RealSynarix/CustomMouse/(list of files, cad)

Other CAD files:
Hardware/Models/model.stl
