RealSynarix/CustomMouse/Hardware/PCB/Schematic_KiCAD.sch

## KiCad design Hardware/PCB/Schematic_KiCAD.sch (2026-02-08)

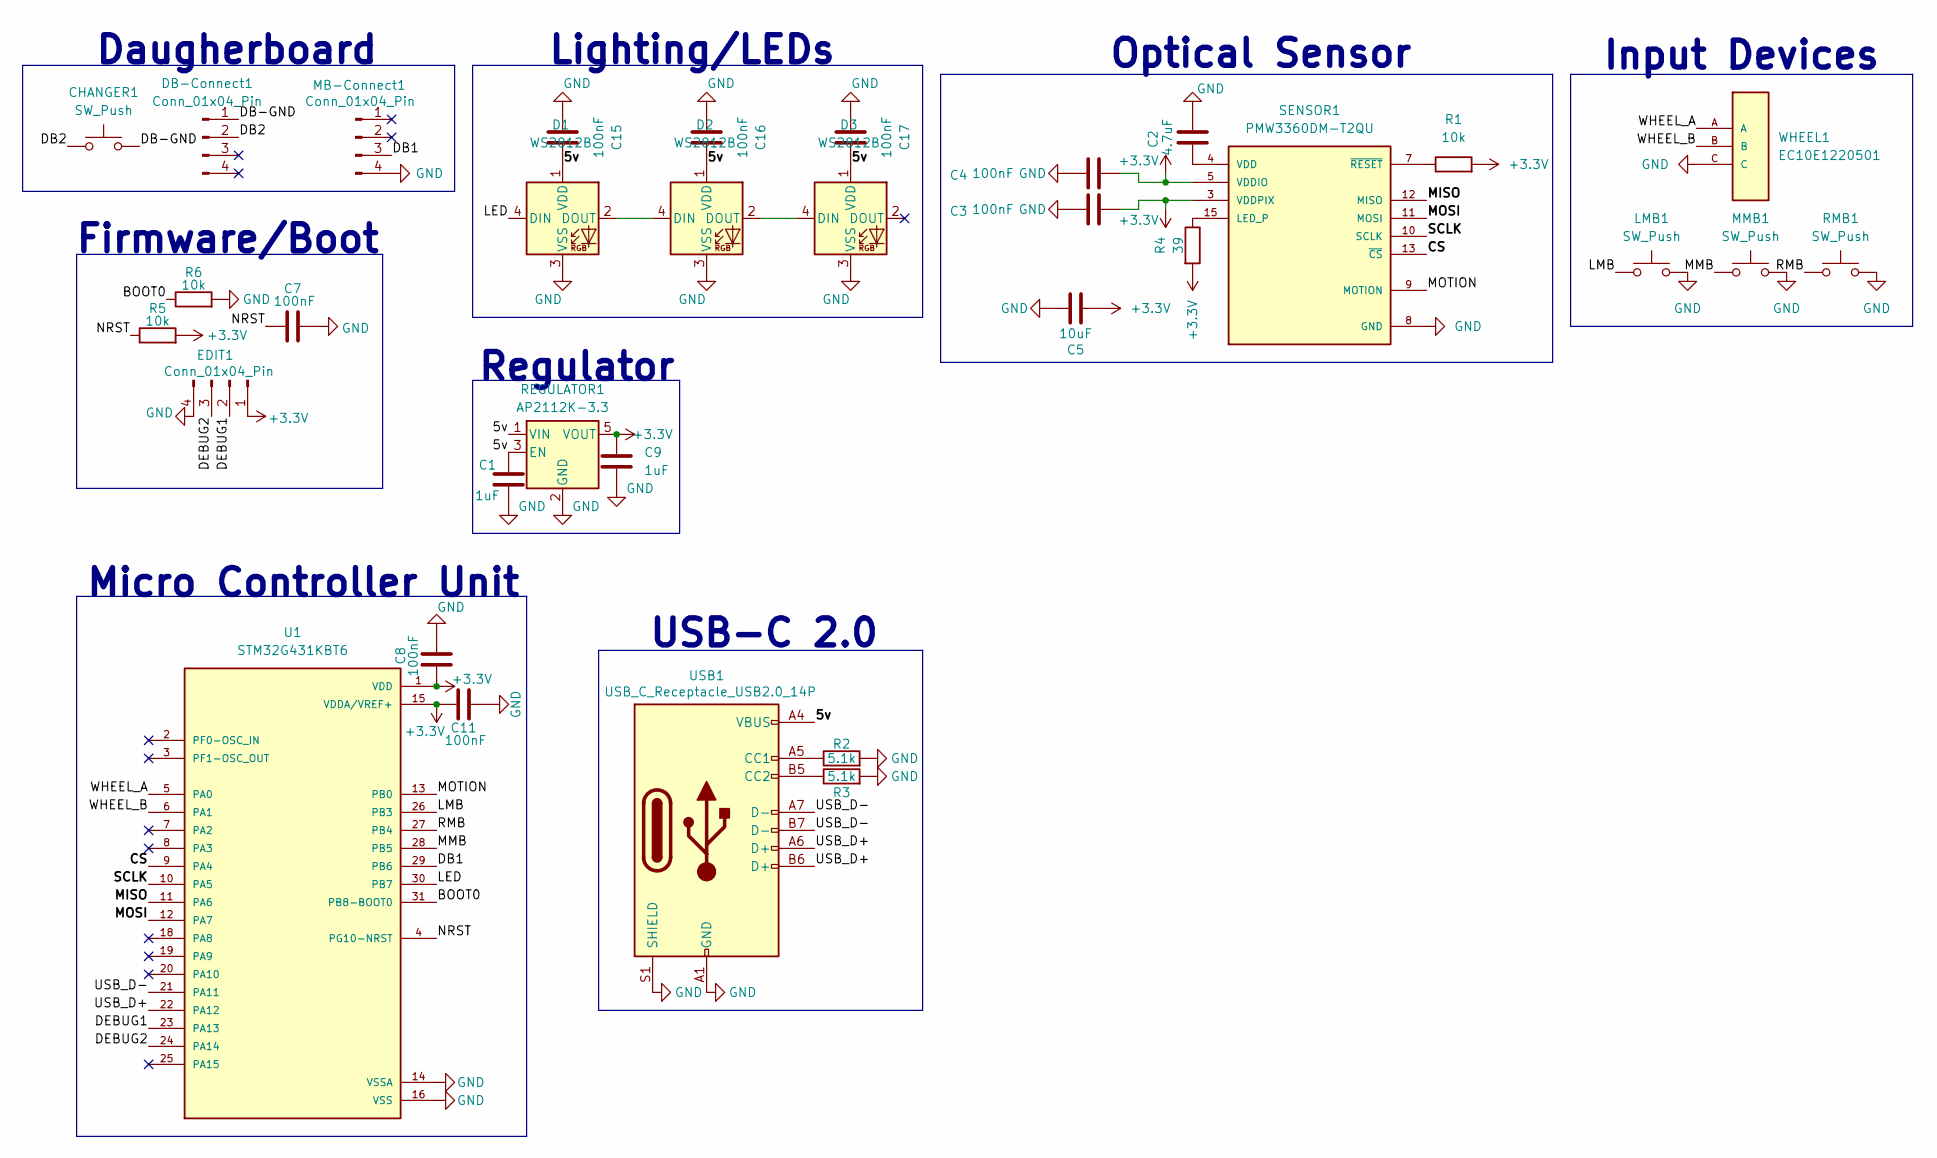
[picture p1: schematic Schematic_KiCAD.sch]

Parts:
C1, C9: 1uF; C_0603_1608Metric
C2: 4.7uF; C_0603_1608Metric
C3, C4, C7, C8, C11, C15, C16, C17: 100nF; C_0603_1608Metric
C5: 10uF; C_0603_1608Metric
CHANGER1: SW_Push; SW_PUSH_6mm_H7.3mm
D1, D2, D3: WS2812B; LED_D5.0mm-4_RGB
DB-Connect1: Conn_01x04_Pin; JST_SH_SM04B-SRSS-TB_1x04-1MP_P1.00mm_Horizontal
EDIT1: Conn_01x04_Pin; PinHeader_1x04_P2.54mm_Vertical
LMB1: SW_Push; SW_PUSH_6mm_H7.3mm
MB-Connect1: Conn_01x04_Pin; JST_SH_SM04B-SRSS-TB_1x04-1MP_P1.00mm_Horizontal
MMB1: SW_Push; SW_PUSH_6mm_H7.3mm
R1, R5, R6: 10k; R_0603_1608Metric
R2, R3: 5.1k; R_0603_1608Metric
R4: 39; R_0603_1608Metric
REGULATOR1: AP2112K-3.3; SOT-23-5
RMB1: SW_Push; SW_PUSH_6mm_H7.3mm
SENSOR1: PMW3360DM-T2QU; PMW3360; MANUFACTURER_PART_NUMBER PMW3360DM-T2QU
U1: STM32G431KBT6; LQFP-32_7x7mm_P0.8mm; PARTREV 2
USB1: USB_C_Receptacle_USB2.0_14P; USB_C_Receptacle_HRO_TYPE-C-31-M-12
WHEEL1: EC10E1220501; TRIM_EC10E1220501

Connections:
5v: C1.1, C15.2, C16.2, C17.2, D1.1 (VDD), D2.1 (VDD), D3.1 (VDD), REGULATOR1.1 (VIN), REGULATOR1.3 (EN), USB1.A4 (VBUS), USB1.A9 (VBUS), USB1.B4 (VBUS), USB1.B9 (VBUS)
+3.3V: C3.1, C4.1, C5.2, C8.1, C9.1, C11.1, EDIT1.1, R1.2, R4.2, R5.2, REGULATOR1.5 (VOUT), SENSOR1.3 (VDDPIX), SENSOR1.5 (VDDIO), U1.1 (VDD), U1.15 (VDDA/VREF+), U1.17 (VDD)
BOOT0: R6.1, U1.31 (PB8-BOOT0)
CS: SENSOR1.13 (~CS), U1.9 (PA4)
DB1: MB-Connect1.3, U1.29 (PB6)
DB2: CHANGER1.1, DB-Connect1.2
DB-GND: CHANGER1.2, DB-Connect1.1
DEBUG1: EDIT1.2, U1.23 (PA13)
DEBUG2: EDIT1.3, U1.24 (PA14)
GND: C1.2, C2.1, C3.2, C4.2, C5.1, C7.2, C8.2, C9.2, C11.2, C15.1, C16.1, C17.1, D1.3 (VSS), D2.3 (VSS), D3.3 (VSS), EDIT1.4, LMB1.2, MB-Connect1.4, MMB1.2, R2.2, R3.2, R6.2, REGULATOR1.2 (GND), RMB1.2, SENSOR1.8 (GND), U1.14 (VSSA), U1.16 (VSS), U1.32 (VSS), USB1.A1 (GND), USB1.A12 (GND), USB1.B1 (GND), USB1.B12 (GND), USB1.S1 (SHIELD), WHEEL1.C
LED: D1.4 (DIN), U1.30 (PB7)
LMB: LMB1.1, U1.26 (PB3)
MISO: SENSOR1.12 (MISO), U1.11 (PA6)
MMB: MMB1.1, U1.28 (PB5)
MOSI: SENSOR1.11 (MOSI), U1.12 (PA7)
MOTION: SENSOR1.9 (MOTION), U1.13 (PB0)
NRST: C7.1, R5.1, U1.4 (PG10-NRST)
unnamed: C2.2, SENSOR1.4 (VDD)
unnamed: D1.2 (DOUT), D2.4 (DIN)
unnamed: D2.2 (DOUT), D3.4 (DIN)
unnamed: R1.1, SENSOR1.7 (~RESET)
unnamed: R2.1, USB1.A5 (CC1)
unnamed: R3.1, USB1.B5 (CC2)
unnamed: R4.1, SENSOR1.15 (LED_P)
RMB: RMB1.1, U1.27 (PB4)
SCLK: SENSOR1.10 (SCLK), U1.10 (PA5)
USB_D+: U1.22 (PA12), USB1.A6 (D+), USB1.B6 (D+)
USB_D-: U1.21 (PA11), USB1.A7 (D-), USB1.B7 (D-)
WHEEL_A: U1.5 (PA0), WHEEL1.A
WHEEL_B: U1.6 (PA1), WHEEL1.B

Notes on the sheet:
Input Devices
USB-C 2.0
Micro Controller Unit
Lighting/LEDs
Optical Sensor
Firmware/Boot
Regulator
Daugherboard
