RealSynarix/CustomMouse/docs/AssemblyGuide.md

Dummy file for now, tell ppl how to setup the mouse and how to flash it, and potentially link to a website to buy the parts in the future

Prereuests (give techincal names in full file):
x1 TTC Gold Rotary Encoder ~$2
x5 Kailh Mute Push Buttons ~$1.5
x1 PMW3360 (wth plastic thing) ~$20
x3 LEDs ~$0.05
