RealSynarix/CustomMouse/docs/HowToFlashFirmware.md

dummy body to tell user how to flash their own firmware or modified firmware onto the PCB via the built in debug pins
