RealSynarix/CustomMouse/(commit log)

2026-02-08 Create AssemblyGuide.md with initial content
    Add placeholder content for assembly guide.
2026-02-11 Create HowToFlashFirmware.md with flashing instructions
    Add instructions for flashing firmware onto PCB.
2026-02-14 Update PCB & PCBA item description in README
2026-02-26 Add TODO list for PCB design fixes
    Document issues and actions needed for PCB design fixes related to LED components, switch orientations, and scroll wheel dimensions.
2026-02-26 Update TODO with new issues and actions
    Added new issues and actions for scroll wheel, daughterboard connector, and firmware jumper pins.
2026-02-26 Fix spelling and clarity issues in documentation
    Corrected spelling errors and improved clarity in the documentation regarding the custom mouse project, including sections on concept, design, issues, prototype, firmware, and overall information.
2026-02-28 Update and rename Hardware/Schematic_KiCAD.sch to Hardware/PCB/Schematic_KiCAD.sch
    [Schematic_KiCAD.sch]
2026-02-28 Fix formatting issues in BOM.csv
    Updated BOM.csv to correct formatting and remove extra lines.
    [BOM.csv]
2026-02-28 Add assembly guide with setup and parts list
    Added initial setup instructions and component list for assembly.
2026-03-04 Update and rename POS.csv to CPL.csv
    [CPL.csv]
2026-03-04 Revise BOM with new components and corrections
    Updated BOM.csv to include new components and correct designators.
    [BOM.csv]
2026-03-07 Add development history and project revisions
    Documented the development history and revisions of the project, including design pivots, prototype issues, and final assembly processes.
