RealSynarix/CustomMouse/(notices)

Notices in the files:
README.md:
License: GPL v3
License: CC BY-SA 4.0
